MakeItHackin/SecretSanta2020/README.md

# SecretSanta2020
Overview of Reddit Secret Santa gift from 2020

Watch the Demo Here:
https://youtu.be/uKTaNg_Iy-Q

Review the User Guide PDF for details
