MakeItHackin/SecretSanta2020/PCB Files/Build of Materials/RedditSecretSanta2020_2_BOM.xlsx

Part | Value | Package | Description | QTY 1 BOARD | QTY 2 BOARDS | QTY ON HAND | QTY TO ORDER
A,B,DOWN,LEFT,RIGHT,UP, RESET | 5_1_SPST | 5_1_SPST | FLAT BUTTON | 7 | 14 | enough | 0
BATTERY_ON_OFF | 3PINSWITCHMINI | 3PINMINI | MINI SWITCH | 1 | 2 | enough | 0
C1,2 | 10uF | C0805 | CAPACITOR, American symbol | 2 | 4 | enough | 0
LED1-9 |  | SML0805 | LED | 9 | 18 | enough | 0
NEO1-10 | NEOPIXEL5050 | NEOPIXEL5050 |  | 10 | 20 | 40 | order for future
OLED | DISPLAY-OLED-128X32 | DISPLAY-OLED-128X32 | 128x32 Dot Matrix OLED Module with I2C - SSD1306 chip | 1 | 2 | enough | 0
PH1 | A1060_11 | T0-46-A10XX | Sensor Robust Light Sensing Applications | 1 | 2 | enough | 0
R1,11 | 470 | R0805 | RESISTOR, American symbol | 2 | 4 | enough | 0
R2 | 10k | R0805 | RESISTOR, American symbol | 1 | 2 | enough | 0
R 3,4,5,6,7,8,9,10,12,15 | 330 | R0805 | RESISTOR, American symbol | 10 | 20 | enough | 0
R16,17 | 100k | R0805 | RESISTOR, American symbol | 2 | 4 | enough | 0
SP1 | SPEAKER/AL60P | AL60P | SPEAKER Source: BuerklinAdded PS12 | 1 | 2 | 10 | order for future
U$1 | ARDUINO NANO V3.0 | ARDUINO-NANO-3.0 | Arduino Nano 3.0 and compatible devices | 1 | 2 | 0 | pack
U$2 | REAL TIME CLOCK - DS3231 | RTC-DS3231-AT24C32 | RTC Module with Battery and EEPROM based on DS3231 | 1 | 2 | 0 | pack
U$4 | BATTERY-LI-MH1221018650_SMD | BATTERY_18650_SMD | Lithium-Ion MH12210 Rechargeable Battery | 1 | 2 | enough | 0
U$6 | BATTERY CHARGER | BAT_CHARGE_LOW_FP | Lithium Battery 5V Charger with protection circuit | 1 | 2 | 0 | pack
U$7 | DC POWER BOOST MODULE | DC-DC-STEP-UP-LOW_FP | DC/DC Step-Up Regulator based on MT3608 chip | 1 | 2 | 0 | pack
 | 18650 Battery Holder |  |  | 1 | 2 | 0 | pack
 | 3D printed Base |  |  | 1 | 2 | 0 | make
 | Mini Screws |  |  | 2 | 4 | enough | 0
 | Mini Washers |  |  | 4 | 8 | enough | 0
 | Mini Nuts |  |  | 2 | 4 | enough | 0
