MakeItHackin/SecretSanta2020/PCB Files/EAGLE/RedditSecretSanta2020_2.brd

## EAGLE design PCB Files/EAGLE/RedditSecretSanta2020_2.brd (2020-12-21)

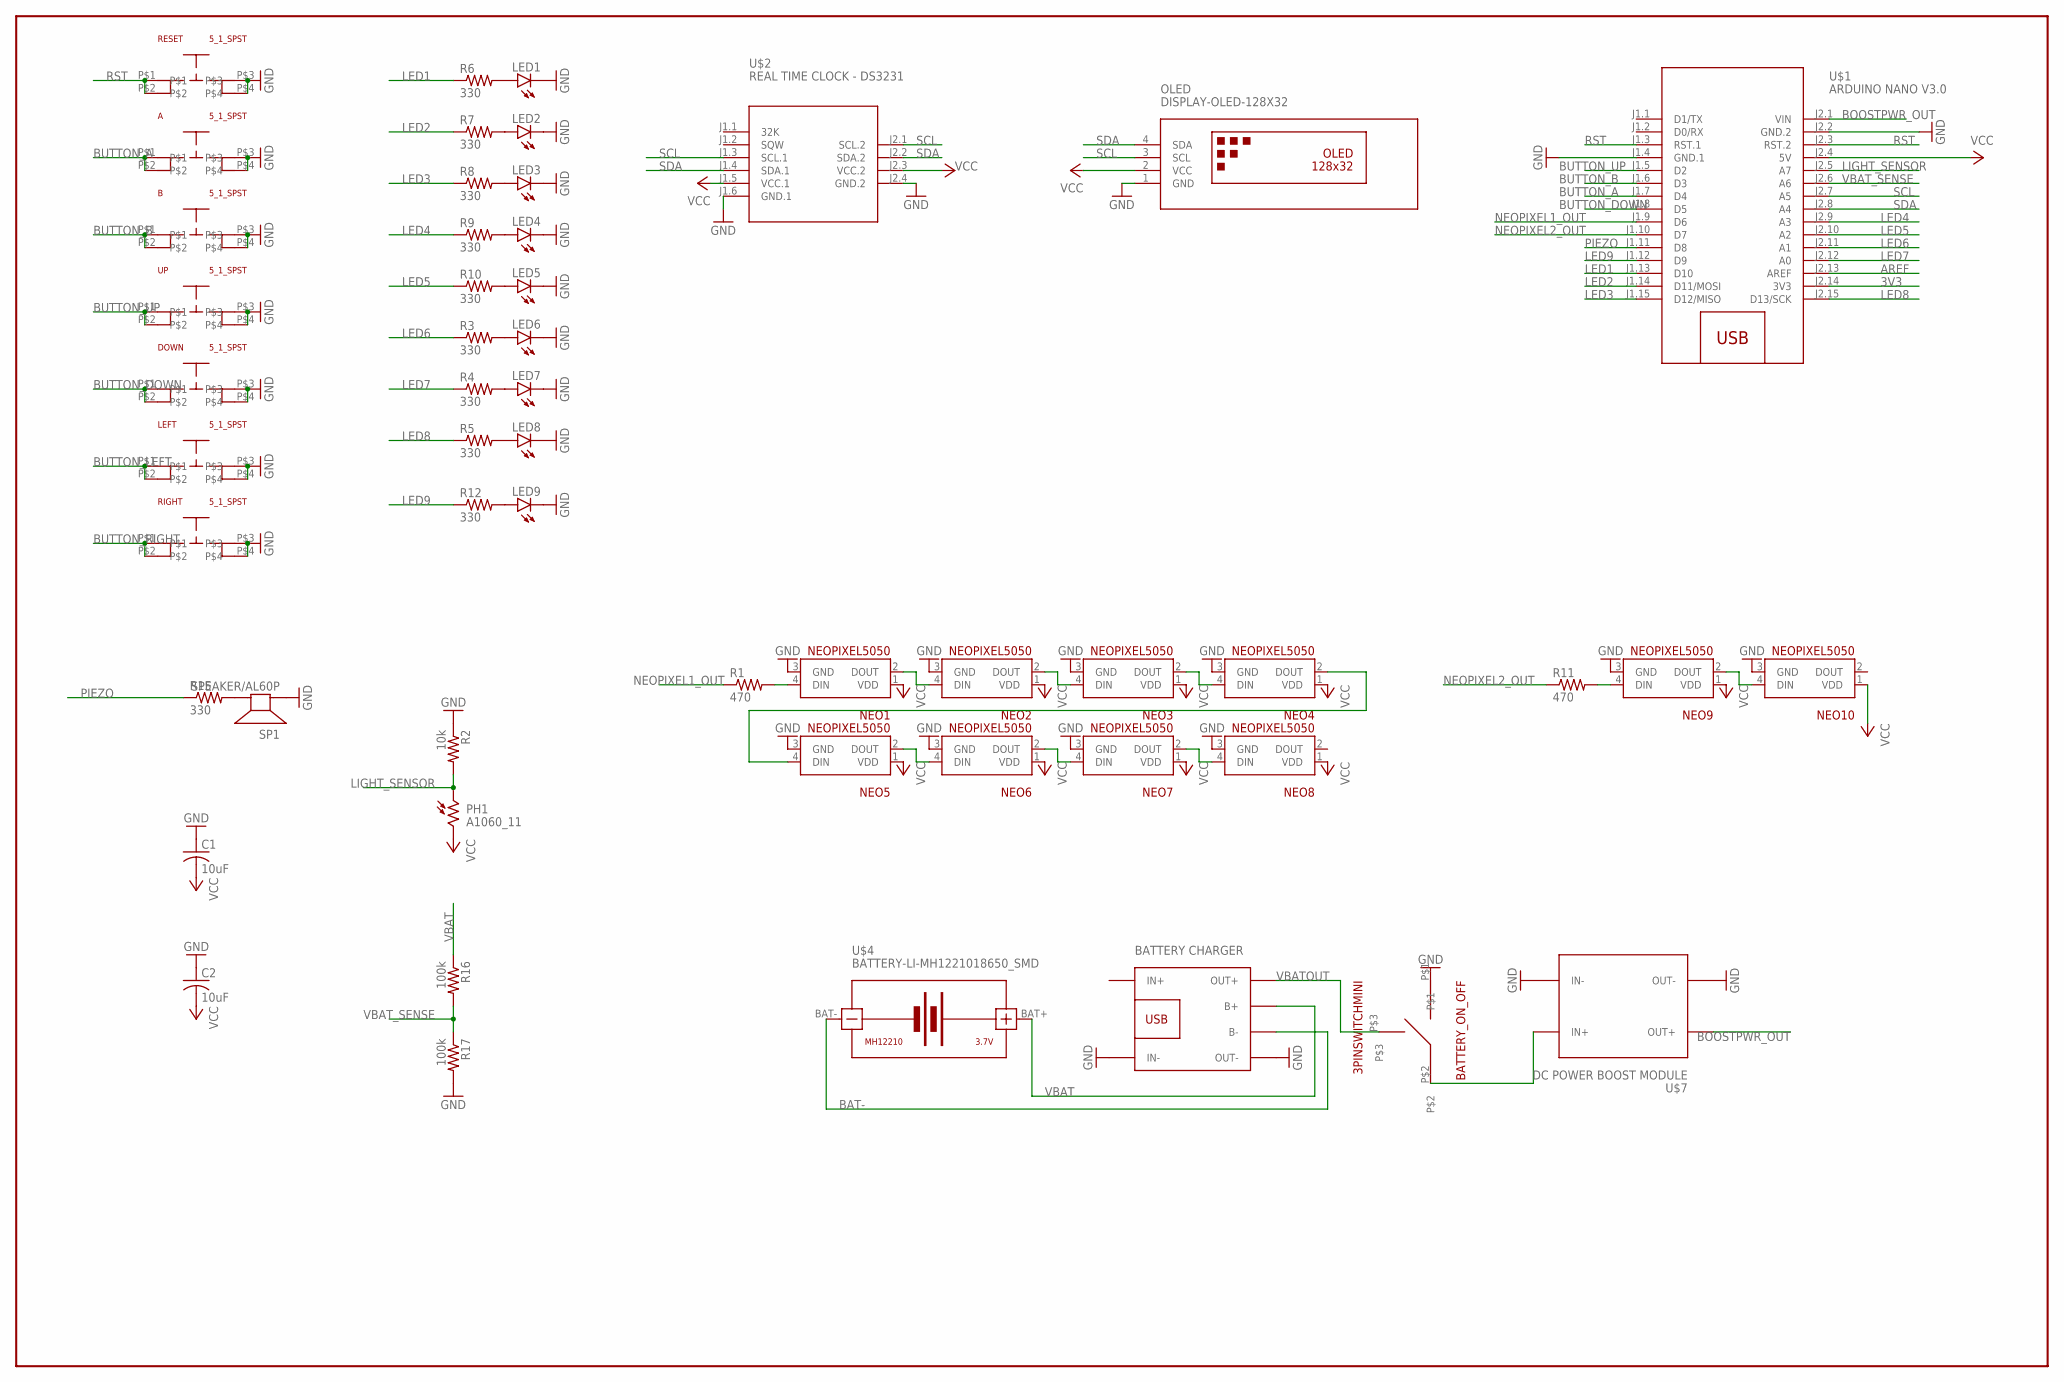
[picture p7: schematic RedditSecretSanta2020_2.sch]

Parts:
A: 5_1_SPST
B: 5_1_SPST
BATTERY_ON_OFF: 3PINSWITCHMINI; 3PINMINI
C1, C2: 10uF; C0805
DOWN: 5_1_SPST
LED1, LED2, LED3, LED4, LED5, LED6, LED7, LED8, LED9: LEDSML0805; SML0805
LEFT: 5_1_SPST
NEO1, NEO2, NEO3, NEO4, NEO5, NEO6, NEO7, NEO8, NEO9, NEO10: NEOPIXEL5050
OLED: DISPLAY-OLED-128X32
PH1: A1060_11; T0-46-A10XX
R1, R11: 470; R0805
R2: 10k; R0805
R3, R4, R5, R6, R7, R8, R9, R10, R12, R15: 330; R0805
R16, R17: 100k; R0805
RESET: 5_1_SPST
RIGHT: 5_1_SPST
SP1: SPEAKER/AL60P; AL60P
U$1: ARDUINO NANO V3.0; ARDUINO-NANO-3.0
U$2: REAL TIME CLOCK - DS3231; RTC-DS3231-AT24C32
U$4: BATTERY-LI-MH1221018650_SMD; BATTERY_18650_SMD
U$6: BATTERY CHARGER; BAT_CHARGE_LOW_FP
U$7: DC POWER BOOST MODULE; DC-DC-STEP-UP-LOW_FP
UP: 5_1_SPST

Connections:
3V3: U$1.J2.14 (3V3)
AREF: U$1.J2.13 (AREF)
BAT-: U$4.BAT-, U$6.B-
BOOSTPWR_OUT: U$1.J2.1 (VIN), U$7.OUT+
BUTTON_A: A.P$1, A.P$2, U$1.J1.7 (D4)
BUTTON_B: B.P$1, B.P$2, U$1.J1.6 (D3)
BUTTON_DOWN: DOWN.P$1, DOWN.P$2, U$1.J1.8 (D5)
BUTTON_LEFT: LEFT.P$1, LEFT.P$2
BUTTON_RIGHT: RIGHT.P$1, RIGHT.P$2
BUTTON_UP: U$1.J1.5 (D2), UP.P$1, UP.P$2
GND: A.P$3, A.P$4, B.P$3, B.P$4, BATTERY_ON_OFF.P$1, C1.1, C2.1, DOWN.P$3, DOWN.P$4, LED1.C, LED2.C, LED3.C, LED4.C, LED5.C, LED6.C, LED7.C, LED8.C, LED9.C, LEFT.P$3, LEFT.P$4, NEO1.3 (GND), NEO2.3 (GND), NEO3.3 (GND), NEO4.3 (GND), NEO5.3 (GND), NEO6.3 (GND), NEO7.3 (GND), NEO8.3 (GND), NEO9.3 (GND), NEO10.3 (GND), OLED.1 (GND), R2.1, R17.2, RESET.P$3, RESET.P$4, RIGHT.P$3, RIGHT.P$4, SP1.1 (+), U$1.J1.4 (GND.1), U$1.J2.2 (GND.2), U$2.J1.6 (GND.1), U$2.J2.4 (GND.2), U$6.IN-, U$6.OUT-, U$7.IN-, U$7.OUT-, UP.P$3, UP.P$4
LED1: R6.1, U$1.J1.13 (D10)
LED1W: LED1.A, R6.2
LED1W1: LED6.A, R3.2
LED2: R7.1, U$1.J1.14 (D11/MOSI)
LED2W: LED2.A, R7.2
LED2W1: LED7.A, R4.2
LED3: R8.1, U$1.J1.15 (D12/MISO)
LED3W: LED3.A, R8.2
LED3W1: LED8.A, R5.2
LED3W2: LED9.A, R12.2
LED4: R9.1, U$1.J2.9 (A3)
LED4W: LED4.A, R9.2
LED5: R10.1, U$1.J2.10 (A2)
LED5W: LED5.A, R10.2
LED6: R3.1, U$1.J2.11 (A1)
LED7: R4.1, U$1.J2.12 (A0)
LED8: R5.1, U$1.J2.15 (D13/SCK)
LED9: R12.1, U$1.J1.12 (D9)
LIGHT_SENSOR: PH1.1, R2.2, U$1.J2.5 (A7)
unnamed: NEO9.4 (DIN), R11.2
unnamed: R15.2, SP1.2 (-)
unnamed: NEO4.2 (DOUT), NEO5.4 (DIN)
unnamed: NEO1.4 (DIN), R1.2
unnamed: NEO1.2 (DOUT), NEO2.4 (DIN)
unnamed: NEO2.2 (DOUT), NEO3.4 (DIN)
unnamed: NEO3.2 (DOUT), NEO4.4 (DIN)
unnamed: NEO5.2 (DOUT), NEO6.4 (DIN)
unnamed: NEO6.2 (DOUT), NEO7.4 (DIN)
unnamed: NEO7.2 (DOUT), NEO8.4 (DIN)
unnamed: NEO9.2 (DOUT), NEO10.4 (DIN)
NEOPIXEL1_OUT: R1.1, U$1.J1.9 (D6)
NEOPIXEL2_OUT: R11.1, U$1.J1.10 (D7)
PIEZO: R15.1, U$1.J1.11 (D8)
RST: RESET.P$1, RESET.P$2, U$1.J1.3 (RST.1), U$1.J2.3 (RST.2)
SCL: OLED.3 (SCL), U$1.J2.7 (A5), U$2.J1.3 (SCL.1), U$2.J2.1 (SCL.2)
SDA: OLED.4 (SDA), U$1.J2.8 (A4), U$2.J1.4 (SDA.1), U$2.J2.2 (SDA.2)
VBAT: R16.1, U$4.BAT+, U$6.B+
VBATOUT: BATTERY_ON_OFF.P$3, U$6.OUT+
VBAT_SENSE: R16.2, R17.1, U$1.J2.6 (A6)
VBOOST_IN: BATTERY_ON_OFF.P$2, U$7.IN+
VCC: C1.2, C2.2, NEO1.1 (VDD), NEO2.1 (VDD), NEO3.1 (VDD), NEO4.1 (VDD), NEO5.1 (VDD), NEO6.1 (VDD), NEO7.1 (VDD), NEO8.1 (VDD), NEO9.1 (VDD), NEO10.1 (VDD), OLED.2 (VCC), PH1.2, U$1.J2.4 (5V), U$2.J1.5 (VCC.1), U$2.J2.3 (VCC.2)

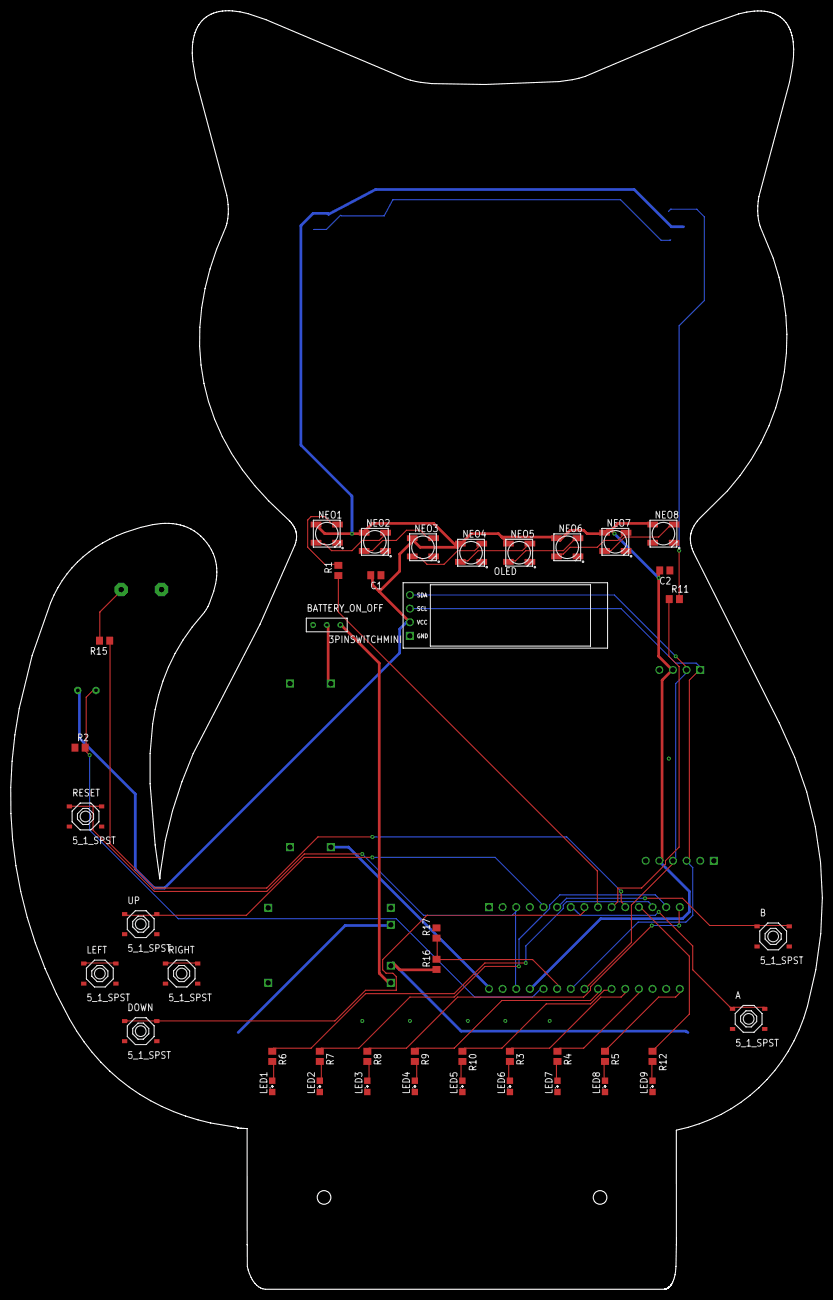
[picture p8: board RedditSecretSanta2020_2.brd from above]

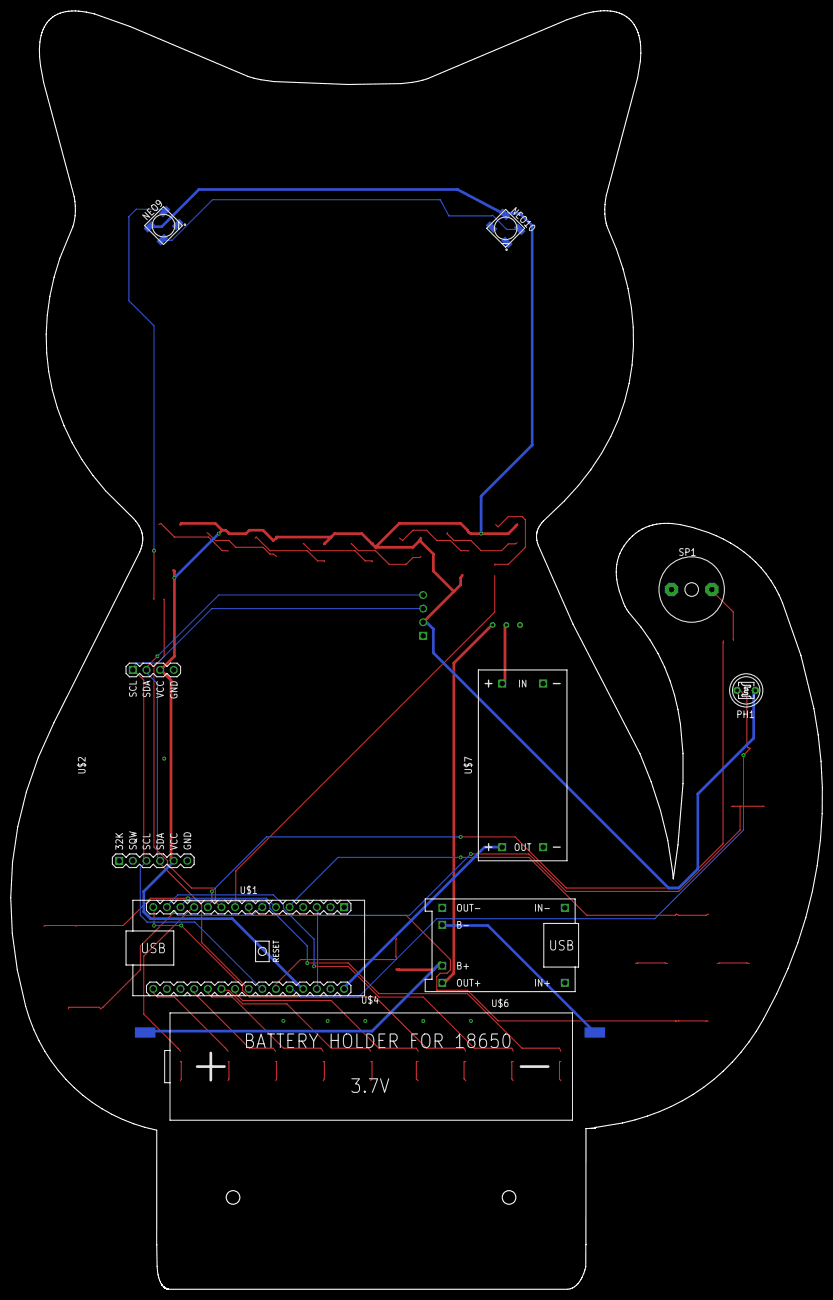
[picture p9: board RedditSecretSanta2020_2.brd from below]

Board: 2 copper layers, 151.2 x 238.3 mm, 52 parts (9 on the bottom side), 50 nets.
