MakeItHackin/SecretSanta2020/(notices)

Notices in the files:
PCB Files/EAGLE/RedditSecretSanta2020_2.brd:
TRADEMARKS AND COPYRIGHT USED WITH ARTISTIC LICENSE. NOT FOR SALE
parts and their libraries:
diy-modules: Released under the Creative Commons Attribution 4.0 International License: http://creativecommons.org/licenses/by/4.0
